albanpetit/labotager/fw-test/images/interface-2.jpg

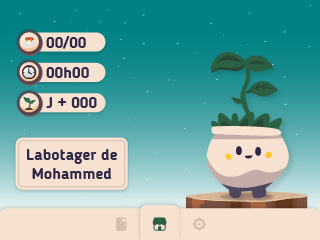
fw-test/images/interface-2.jpg
