albanpetit/labotager/fw-test/images/interface.jpeg

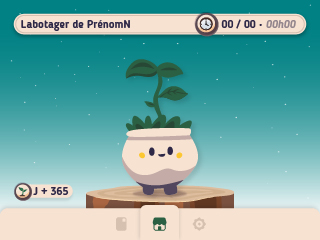
fw-test/images/interface.jpeg
