albanpetit/labotager/fw/tools/images/background.png

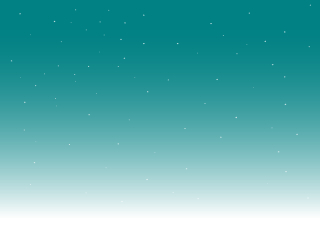
fw/tools/images/background.png
