albanpetit/labotager/fw/tools/images/params_background.png

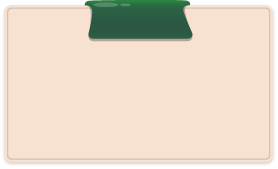
fw/tools/images/params_background.png
