albanpetit/labotager/fw/tools/images/plant_happy.png

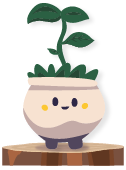
fw/tools/images/plant_happy.png
