albanpetit/labotager/fw/tools/images/plant_unhappy.png

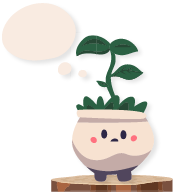
fw/tools/images/plant_unhappy.png
