albanpetit/labotager/mcad/ecad-3d.step

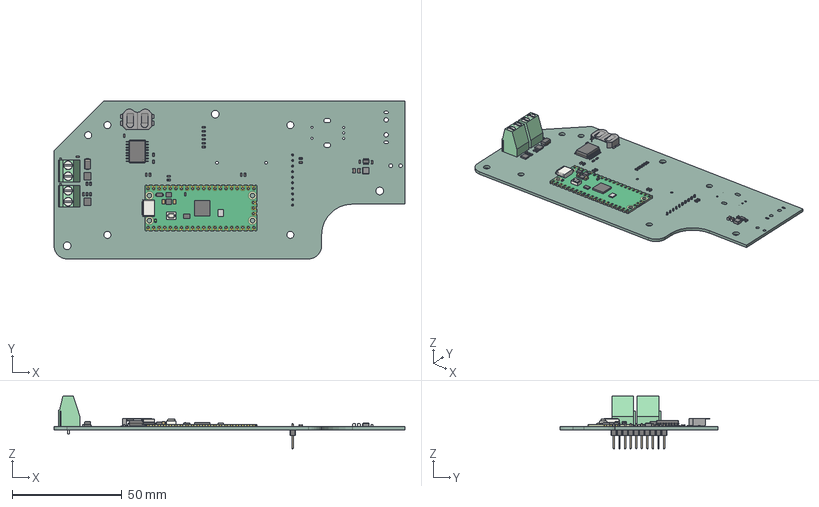
[picture p7: CAD file, 2026-04-15]
mcad/ecad-3d.step
160.0 x 72.0 x 24.0 mm
Diodes_PowerDI3333-8 x 2
C_0603_1608Metric x 13
R_0603_1608Metric x 12
RaspberryPi_Pico_Module_KiCad
C_0805_2012Metric x 2
TerminalBlock_Phoenix_MKDS-1,5-2_1x02_P5.00mm_Horizontal x 2
BatteryHolder_LINX_BAT-HLD-012-SMT
L_Wuerth_MAPI-3015
D_SMA
TSOT-23-6
SOIC-16W_7.5x10.3mm_P1.27mm
PinHeader_1x10_P2.54mm_Vertical
labotager_PCB
