albanpetit/labotager/stencil-support/stencil-support.FCStd

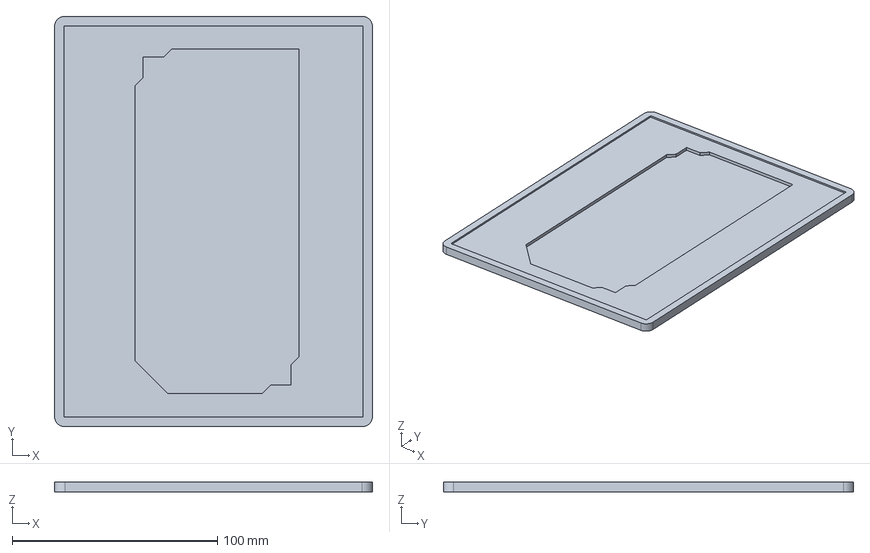
[picture p8: CAD file, 2026-04-15]
stencil-support/stencil-support.FCStd
155.0 x 200.0 x 5.00 mm
