albanpetit/labotager/(list of files, cad)

Other CAD files:
stencil-support/stencil-support.3mf
