albanpetit/labotager/fw-test/images/interface-3.jpg

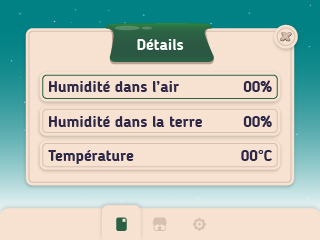
fw-test/images/interface-3.jpg
