albanpetit/labotager/doc/schematic.pdf

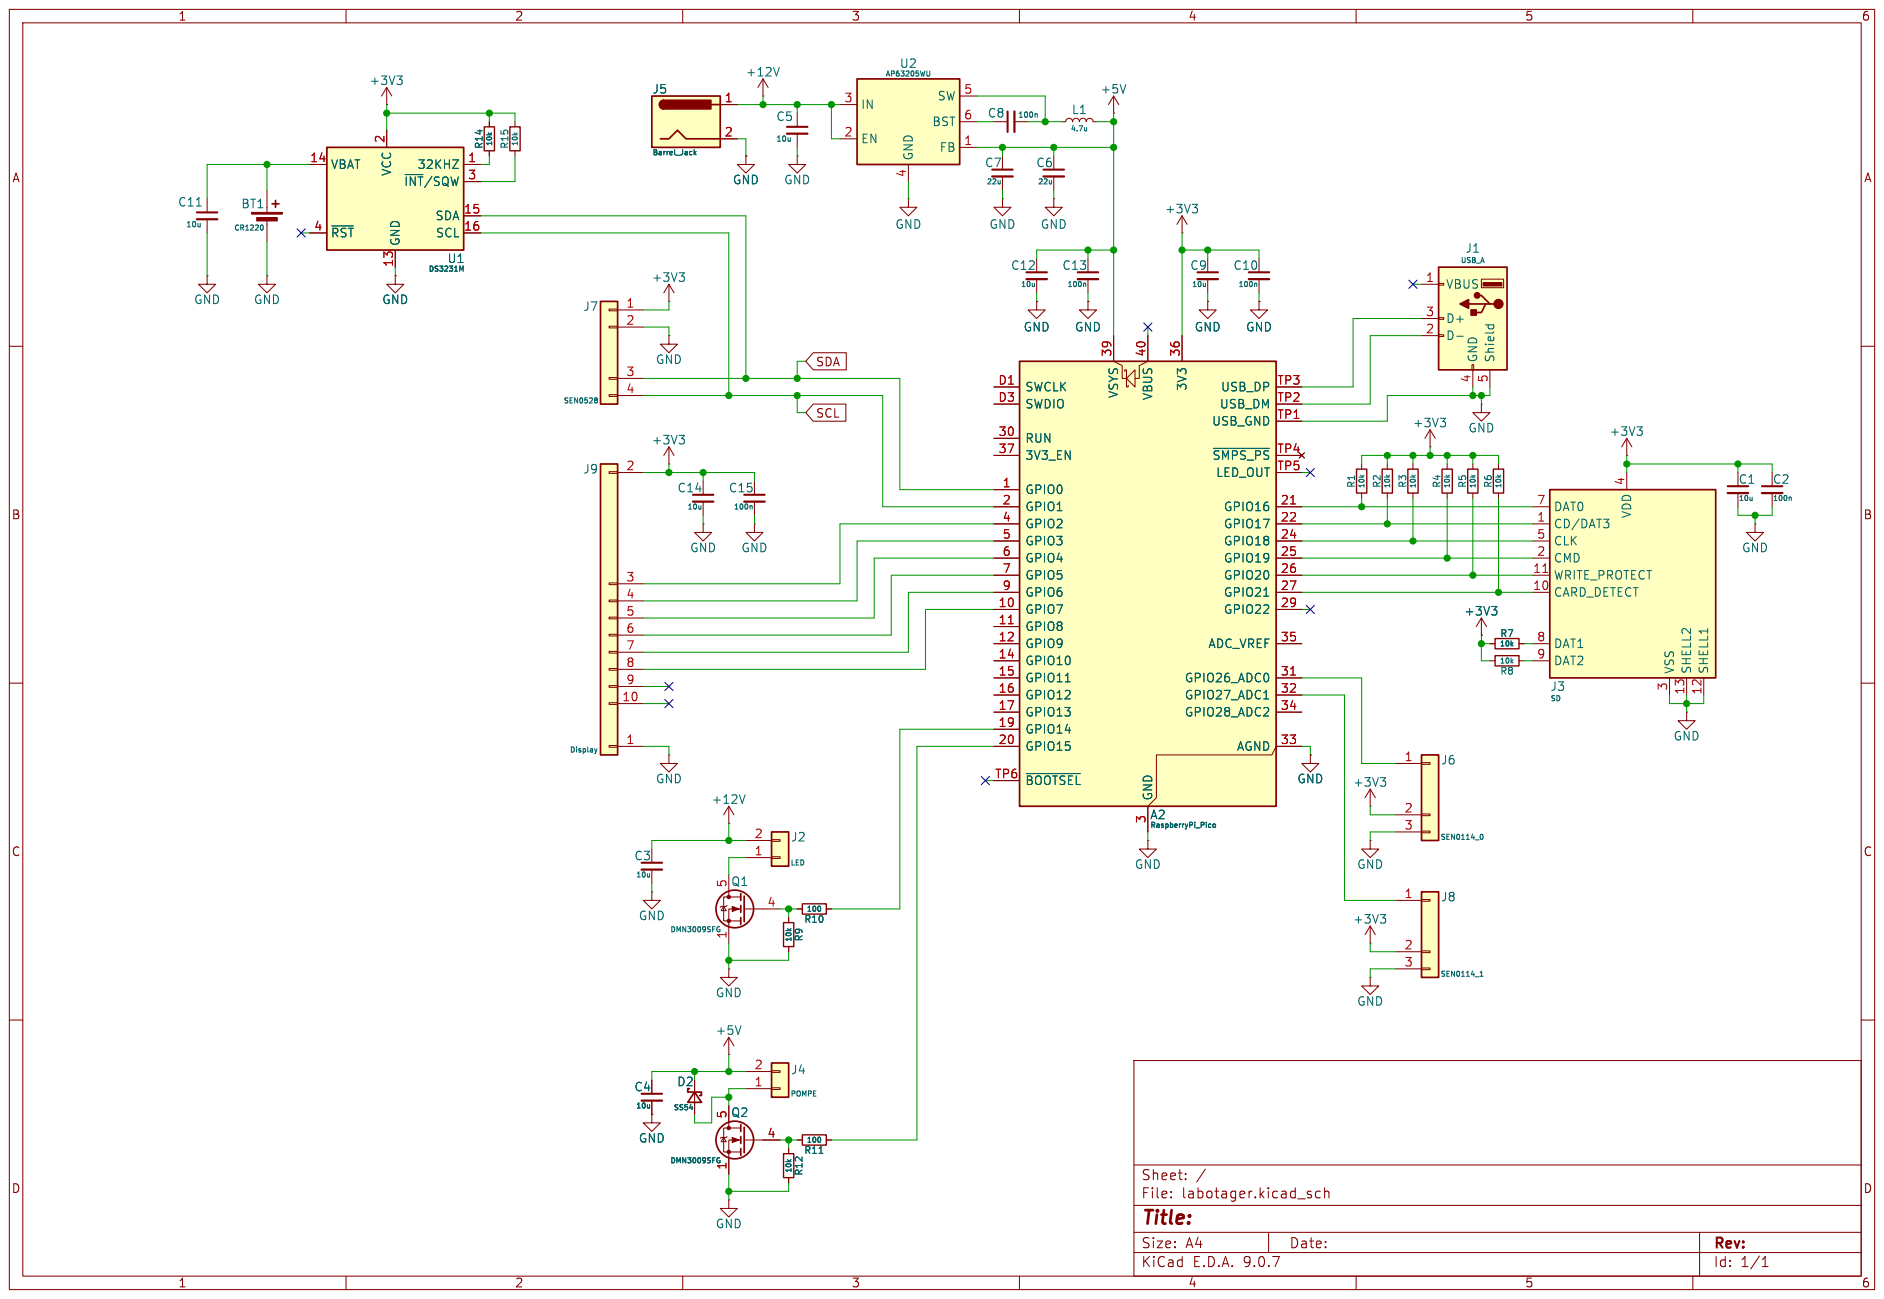
[picture p10: page 1]

Id: 1/1 Title: File: labotager.kicad_sch Sheet: /
