albanpetit/labotager/ecad/labotager.kicad_pcb

## KiCad design ecad/labotager.kicad_pcb (2026-04-15)

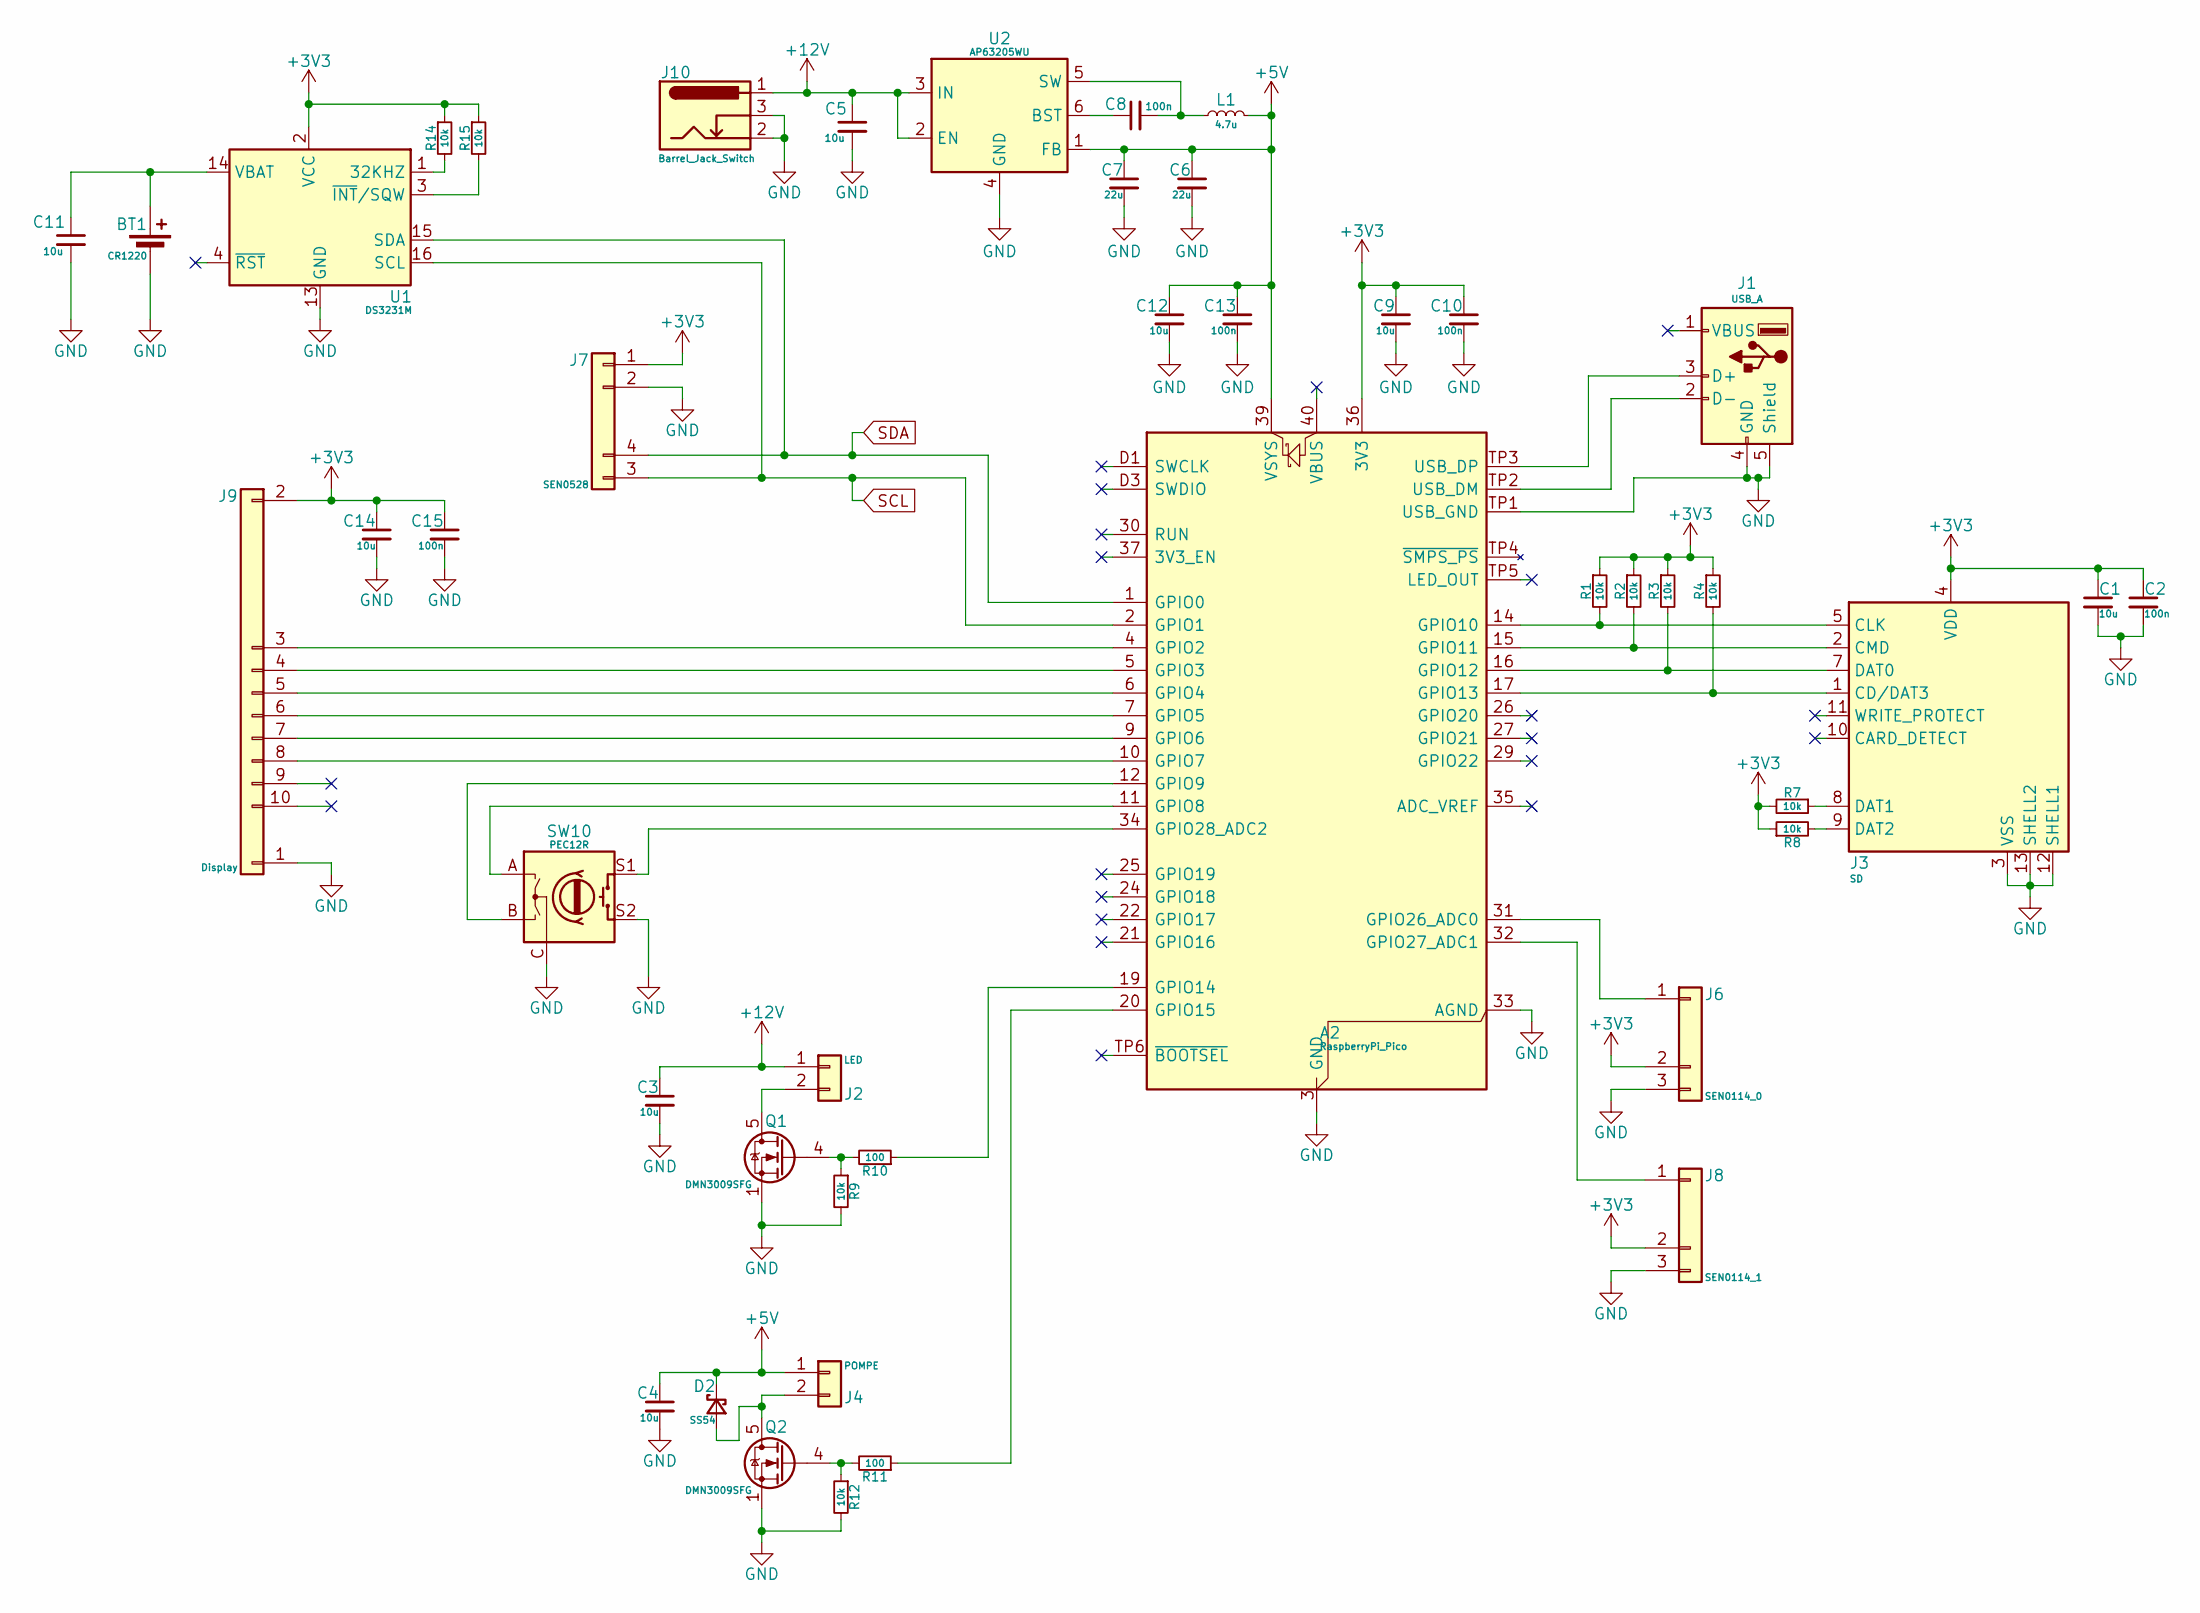
[picture p11: schematic labotager.kicad_sch]

Parts:
A2: RaspberryPi_Pico; RaspberryPi_Pico_SMD
BT1: CR1220; BatteryHolder_LINX_BAT-HLD-012-SMT
C1, C3, C4, C5, C9, C11, C12, C14: 10u; C_0603_1608Metric
C2, C8, C10, C13, C15: 100n; C_0603_1608Metric
C6, C7: 22u; C_0805_2012Metric
D2: SS54; D_SMA
J1: USB_A; USB3_A_Receptacle_Wuerth_692122030100
J2: LED; TerminalBlock_Phoenix_MKDS-1,5-2_1x02_P5.00mm_Horizontal
J3: SD; SD_Hirose_DM1AA_SF_PEJ82
J4: POMPE; TerminalBlock_Phoenix_MKDS-1,5-2_1x02_P5.00mm_Horizontal
J6: SEN0114_0; JST_PH_B3B-PH-SM4-TB_1x03-1MP_P2.00mm_Vertical
J7: SEN0528; JST_PH_B4B-PH-SM4-TB_1x04-1MP_P2.00mm_Vertical
J8: SEN0114_1; JST_PH_B3B-PH-SM4-TB_1x03-1MP_P2.00mm_Vertical
J9: Display; PinHeader_1x10_P2.54mm_Vertical
J10: Barrel_Jack_Switch; BarrelJack_Wuerth_694106106102_2.0x5.5mm
L1: 4.7u; L_Wuerth_MAPI-3015
Q1, Q2: DMN3009SFG; Diodes_PowerDI3333-8
R1, R2, R3, R4, R7, R8, R9, R12, R14, R15: 10k; R_0603_1608Metric
R10, R11: 100; R_0603_1608Metric
SW10: PEC12R; RotaryEncoder_Bourns_Vertical_PEC12R-3x17F-Sxxxx
U1: DS3231M; SOIC-16W_7.5x10.3mm_P1.27mm
U2: AP63205WU; TSOT-23-6

Connections:
+3V3: A2.36 (3V3), C1.1, C2.1, C9.1, C10.1, C14.1, C15.1, J3.4 (VDD), J6.2, J7.1, J8.2, J9.2, R1.1, R2.1, R3.1, R4.1, R7.2, R8.1, R14.1, R15.1, U1.2 (VCC)
+5V: A2.39 (VSYS), C4.1, C6.1, C7.1, C12.1, C13.1, D2.1 (K), J4.1, L1.2, U2.1 (FB)
+12V: C3.1, C5.1, J2.1, J10.1, U2.2 (EN), U2.3 (IN)
GND: A2.3 (GND), A2.8 (GND), A2.13 (GND), A2.18 (GND), A2.23 (GND), A2.28 (GND), A2.33 (AGND), A2.38 (GND), A2.D2 (GND), A2.TP1 (USB_GND), BT1.2 (-), C1.2, C2.2, C3.2, C4.2, C5.2, C6.2, C7.2, C9.2, C10.2, C11.2, C12.2, C13.2, C14.2, C15.2, J1.4 (GND), J1.5 (Shield), J3.3 (VSS), J3.6 (VSS), J3.12 (SHELL1), J3.13 (SHELL2), J6.3, J7.2, J8.3, J9.1, J10.2, J10.3, Q1.1 (S), Q1.2 (S), Q1.3 (S), Q2.1 (S), Q2.2 (S), Q2.3 (S), R9.2, R12.2, SW10.C, SW10.S2, U1.5 (GND), U1.6 (GND), U1.7 (GND), U1.8 (GND), U1.9 (GND), U1.10 (GND), U1.11 (GND), U1.12 (GND), U1.13 (GND), U2.4 (GND)
unnamed: A2.4 (GPIO2), J9.3
unnamed: A2.5 (GPIO3), J9.4
unnamed: A2.6 (GPIO4), J9.5
unnamed: A2.7 (GPIO5), J9.6
unnamed: A2.9 (GPIO6), J9.7
unnamed: A2.10 (GPIO7), J9.8
unnamed: A2.11 (GPIO8), SW10.A
unnamed: A2.12 (GPIO9), SW10.B
unnamed: A2.14 (GPIO10), J3.5 (CLK), R1.2
unnamed: A2.15 (GPIO11), J3.2 (CMD), R2.2
unnamed: A2.16 (GPIO12), J3.7 (DAT0), R3.2
unnamed: A2.17 (GPIO13), J3.1 (CD/DAT3), R4.2
unnamed: A2.19 (GPIO14), R10.1
unnamed: A2.20 (GPIO15), R11.1
unnamed: A2.31 (GPIO26_ADC0), J6.1
unnamed: A2.32 (GPIO27_ADC1), J8.1
unnamed: A2.34 (GPIO28_ADC2), SW10.S1
unnamed: A2.TP2 (USB_DM), J1.2 (D-)
unnamed: A2.TP3 (USB_DP), J1.3 (D+)
unnamed: BT1.1 (+), C11.1, U1.14 (VBAT)
unnamed: D2.2 (A), J4.2, Q2.5 (D)
unnamed: J2.2, Q1.5 (D)
unnamed: J3.8 (DAT1), R7.1
unnamed: J3.9 (DAT2), R8.2
unnamed: Q1.4 (G), R9.1, R10.2
unnamed: Q2.4 (G), R11.2, R12.1
unnamed: R14.2, U1.1 (32KHZ)
unnamed: R15.2, U1.3 (~INT/SQW)
unnamed: C8.1, U2.6 (BST)
unnamed: C8.2, L1.1, U2.5 (SW)
SCL: A2.2 (GPIO1), J7.3, U1.16 (SCL)
SDA: A2.1 (GPIO0), J7.4, U1.15 (SDA)

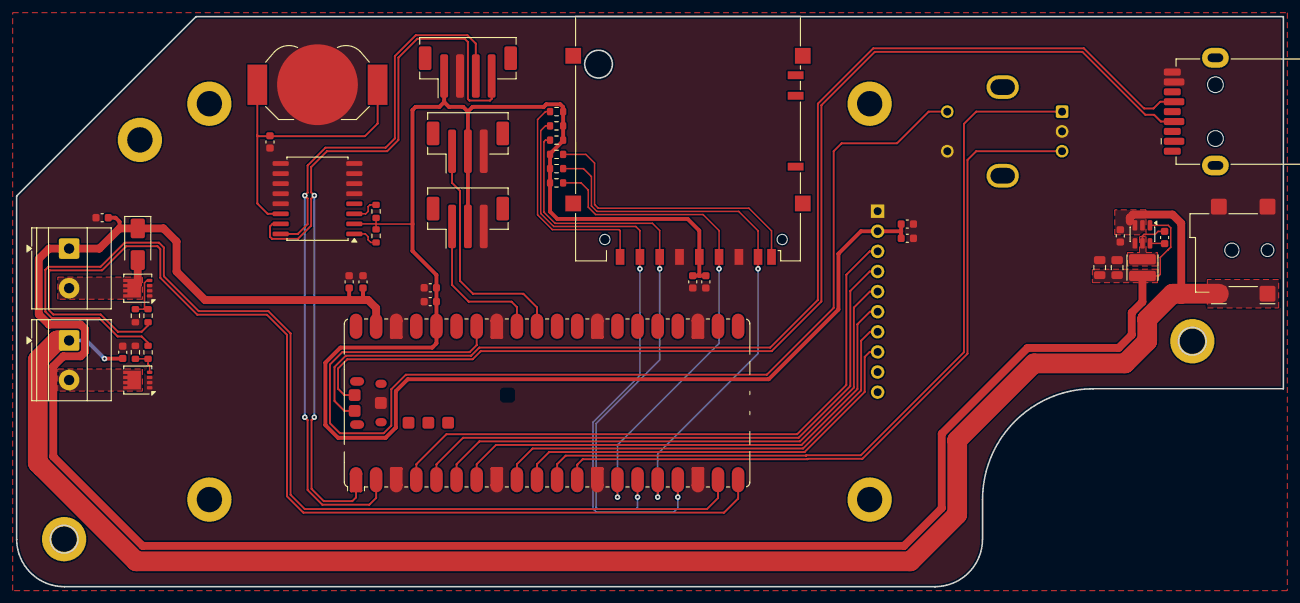
[picture p12: board labotager.kicad_pcb from above]

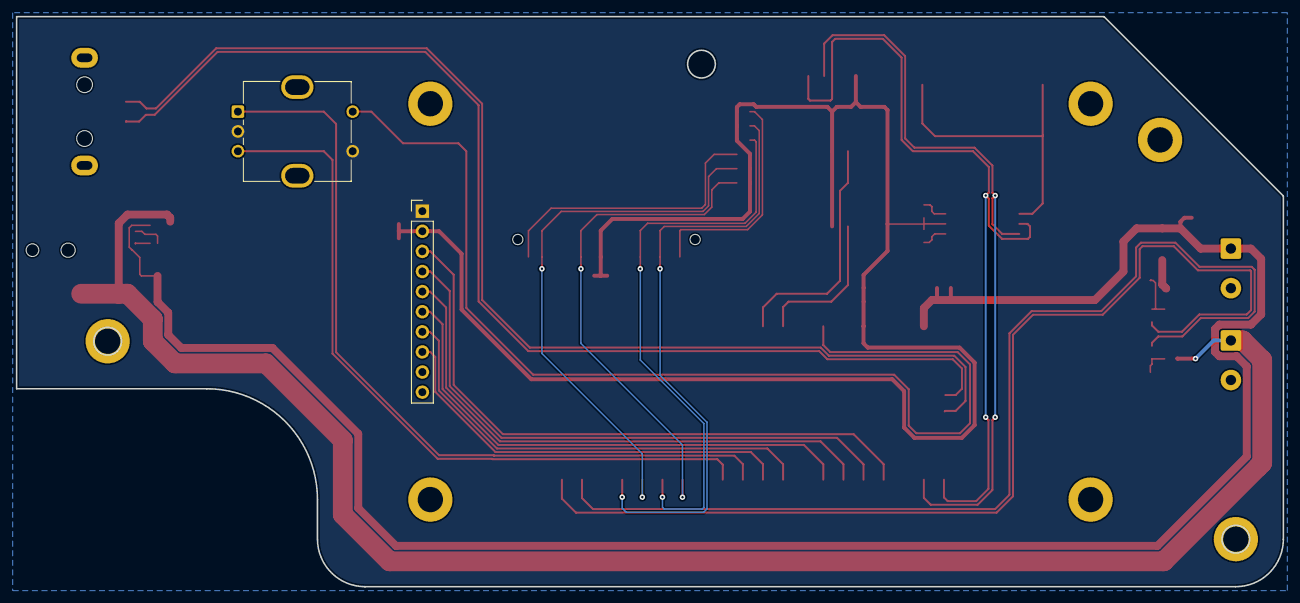
[picture p13: board labotager.kicad_pcb from below]

Board: 2 copper layers, 160.0 x 72.0 mm, 45 parts (2 on the bottom side), 36 nets.
