albanpetit/labotager/fw/src/hw/rtc_mgr.cpp

#include "rtc_mgr.h"
#include "config.h"
#include <Arduino.h>
#include <Wire.h>
#include <DFRobot_DS3231M.h>

// Shared I2C bus (defined in main.cpp)
extern MbedI2C rtcWire;

// RTC update interval
#define RTC_READ_INTERVAL_MS  1000   // minimum time between successive getNowTime() calls (ms)

// DS3231M register addresses (datasheet section 8.2)
#define DS3231_REG_SECONDS   0x00   // start of time registers (seconds … year)
#define DS3231_REG_DOW       0x03   // day-of-week register (not used for time reads)
#define DS3231_REG_STATUS    0x0F   // status register
#define DS3231_STATUS_OSF    0x80   // bit 7 — Oscillator Stop Flag (clear to confirm time is valid)

static DFRobot_DS3231M rtc(&rtcWire);
static bool rtc_failed = false;

// ─── Public ───────────────────────────────────────────────────────────────────

void rtc_init() {
  if (!rtc.begin()) {
    if (Serial) Serial.println("[RTC] DS3231M not detected on I2C bus (addr=0x68) — check wiring");
    rtc_failed = true;
    return;
  }
  if (Serial) Serial.println("[RTC] DS3231M detected and running");

  if (rtc.lostPower()) {
    if (Serial) Serial.println("[RTC] Oscillator was stopped (OSF flag set) — restoring time from build timestamp");

    // Parse __DATE__ ("Mmm DD YYYY") and __TIME__ ("HH:MM:SS") at compile time.
    // Using our own rtc_set_datetime() is explicit and reliable unlike rtc.adjust().
    const char *months = "JanFebMarAprMayJunJulAugSepOctNovDec";
    uint8_t mon = 1;
    for (uint8_t i = 0; i < 12; i++) {
      if (strncmp(__DATE__, months + i * 3, 3) == 0) { mon = i + 1; break; }
    }
    uint8_t  d   = (uint8_t)atoi(__DATE__ + 4);
    uint16_t y   = (uint16_t)atoi(__DATE__ + 7);
    uint8_t  h   = (uint8_t)atoi(__TIME__);
    uint8_t  mi  = (uint8_t)atoi(__TIME__ + 3);
    uint8_t  sec = (uint8_t)atoi(__TIME__ + 6);
    rtc_set_datetime(y, mon, d, h, mi, sec);
  }
}

void rtc_update(SensorData &data) {
  data.rtc_error = rtc_failed;
  if (rtc_failed) return;

  static uint32_t last_read = 0;
  uint32_t now = millis();
  if (now - last_read < RTC_READ_INTERVAL_MS) return;
  last_read = now;

  rtc.getNowTime();

  data.hour      = rtc.hour();
  data.minute    = rtc.minute();
  data.second    = rtc.second();
  data.day       = rtc.day();
  data.month     = rtc.month();
  data.year      = rtc.year();
  data.rtc_ready = true;
}

// Direct register write to DS3231M over I2C.
// Values are BCD-encoded before writing.
// The DFRobot library uses 1970 as year base: stored byte = year - 1970.
void rtc_set_datetime(uint16_t year, uint8_t month, uint8_t day,
                      uint8_t hour, uint8_t minute, uint8_t second) {
  auto to_bcd = [](uint8_t v) -> uint8_t {
    return ((v / 10) << 4) | (v % 10);
  };

  // DS3231M register map — write starting at the seconds register
  rtcWire.beginTransmission(DS3231_ADDR);
  rtcWire.write(DS3231_REG_SECONDS);              // start address
  rtcWire.write(to_bcd(second));                  // 0x00 — seconds
  rtcWire.write(to_bcd(minute));                  // 0x01 — minutes
  rtcWire.write(to_bcd(hour));                    // 0x02 — hours (24-h mode, bits 7:6 = 0)
  rtcWire.write(1);                                // 0x03 — day-of-week (unused, fixed at 1)
  rtcWire.write(to_bcd(day));                     // 0x04 — day-of-month
  rtcWire.write(to_bcd(month));                   // 0x05 — month (century bit 7 = 0)
  rtcWire.write(to_bcd((uint8_t)(year - 1970)));  // 0x06 — year offset from 1970 (DFRobot convention)
  rtcWire.endTransmission();

  // Clear the OSF (Oscillator Stop Flag) in the status register.
  // Without this lostPower() stays true on the next boot and overwrites the time.
  rtcWire.beginTransmission(DS3231_ADDR);
  rtcWire.write(DS3231_REG_STATUS);
  rtcWire.endTransmission();
  rtcWire.requestFrom((int)DS3231_ADDR, 1);
  int raw_status = rtcWire.read();
  if (raw_status >= 0) {
    rtcWire.beginTransmission(DS3231_ADDR);
    rtcWire.write(DS3231_REG_STATUS);
    rtcWire.write((uint8_t)raw_status & ~DS3231_STATUS_OSF);
    rtcWire.endTransmission();
  }

  char buf[56];
  snprintf(buf, sizeof(buf), "[RTC] Time set to %04d-%02d-%02d %02d:%02d:%02d",
      year, month, day, hour, minute, second);
  if (Serial) Serial.println(buf);
}
