albanpetit/labotager/fw-test/src/interface.h

// array size is 64031
static const unsigned char interface[] PROGMEM  = {
  0x89, 0x50, 0x4e, 0x47, 0x0d, 0x0a, 0x1a, 0x0a, 0x00, 0x00, 0x00, 0x0d, 0x49, 0x48, 0x44, 0x52, 
  0x00, 0x00, 0x01, 0x40, 0x00, 0x00, 0x00, 0xf0, 0x08, 0x02, 0x00, 0x00, 0x00, 0xfe, 0x4f, 0x2a, 
  0x3c, 0x00, 0x00, 0x00, 0x01, 0x73, 0x52, 0x47, 0x42, 0x00, 0xae, 0xce, 0x1c, 0xe9, 0x00, 0x00, 
  0x00, 0xf2, 0x65, 0x58, 0x49, 0x66, 0x4d, 0x4d, 0x00, 0x2a, 0x00, 0x00, 0x00, 0x08, 0x00, 0x07, 
  0x01, 0x12, 0x00, 0x03, 0x00, 0x00, 0x00, 0x01, 0x00, 0x01, 0x00, 0x00, 0x01, 0x1a, 0x00, 0x05, 
  0x00, 0x00, 0x00, 0x01, 0x00, 0x00, 0x00, 0x62, 0x01, 0x1b, 0x00, 0x05, 0x00, 0x00, 0x00, 0x01, 
  0x00, 0x00, 0x00, 0x6a, 0x01, 0x28, 0x00, 0x03, 0x00, 0x00, 0x00, 0x01, 0x00, 0x02, 0x00, 0x00, 
  0x01, 0x31, 0x00, 0x02, 0x00, 0x00, 0x00, 0x21, 0x00, 0x00, 0x00, 0x72, 0x01, 0x32, 0x00, 0x02, 
  0x00, 0x00, 0x00, 0x14, 0x00, 0x00, 0x00, 0x94, 0x87, 0x69, 0x00, 0x04, 0x00, 0x00, 0x00, 0x01, 
  0x00, 0x00, 0x00, 0xa8, 0x00, 0x00, 0x00, 0x00, 0x00, 0x00, 0x00, 0x48, 0x00, 0x00, 0x00, 0x01, 
  0x00, 0x00, 0x00, 0x48, 0x00, 0x00, 0x00, 0x01, 0x41, 0x64, 0x6f, 0x62, 0x65, 0x20, 0x49, 0x6c, 
  0x6c, 0x75, 0x73, 0x74, 0x72, 0x61, 0x74, 0x6f, 0x72, 0x20, 0x33, 0x30, 0x2e, 0x32, 0x20, 0x28, 
  0x57, 0x69, 0x6e, 0x64, 0x6f, 0x77, 0x73, 0x29, 0x00, 0x00, 0x32, 0x30, 0x32, 0x36, 0x3a, 0x30, 
  0x32, 0x3a, 0x31, 0x38, 0x20, 0x31, 0x36, 0x3a, 0x30, 0x38, 0x3a, 0x34, 0x37, 0x00, 0x00, 0x04, 
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
  0x61, 0x64, 0x6f, 0x62, 0x65, 0x2e, 0x63, 0x6f, 0x6d, 0x2f, 0x78, 0x61, 0x70, 0x2f, 0x31, 0x2e, 
  0x30, 0x2f, 0x67, 0x2f, 0x69, 0x6d, 0x67, 0x2f, 0x22, 0x0a, 0x20, 0x20, 0x20, 0x20, 0x20, 0x20, 
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
};
