albanpetit/labotager/(commit log)

2026-04-15 chore: untrack .history, add to .gitignore
    [bom.csv, ecad-3d.step, labotager.kicad_pcb, labotager.kicad_sch, stencil-support.3mf, stencil-support.FCStd]
2026-04-15 fix(fw): change the way to exit params edition for a long press
    [display.cpp]
2026-04-15 fix(fw): change params format for date, h:m
    [display.cpp]
2026-04-15 fix(fw): change params date format to j:m:y
    [display.cpp]
2026-04-15 fix(fw): change light logic, start hour and end hour
    [config.h, display.cpp, lighting.cpp, logger.cpp, main.cpp, state.h]
2026-04-15 feat(fw): change pump logic to trigger on light up hours
2026-04-15 fix(fw): change grow counter setup to fix a start date
    [config.h, display.cpp, logger.cpp, main.cpp, state.h]
2026-04-15 fix(fw): fix screen backlight flag to prevent noise on startup
    [display.cpp]
2026-04-15 fix(fw): fix some bugs
    [encoder.cpp, logger.cpp, rtc_mgr.cpp, ui.cpp]
2026-04-15 fix(fw): fix some errors if light up hour is equal to light off
    [display.cpp]
2026-04-15 fix(fw): fix some sd card error
    [display.cpp, logger.cpp, logger.h, main.cpp, ui.cpp, ui.h]
2026-04-16 fix(fw): fix error with screen on startup
    [display.cpp]
2026-04-16 refactor(fw): improve firmware maintainability
    - Sanitize all config.txt values after loading (settings_sanitize):
    clamps hours, temps, thresholds to valid ranges, guards against
    corrupt or hand-edited config producing invalid runtime state
    - Remove last_log_millis from SensorData — it was logger-internal
    scheduling state leaking into the shared struct; now a static local
    in logger_update()
    - Add named constants for DS3231M register addresses and the OSF bit
    mask (DS3231_REG_SECONDS/DOW/STATUS, DS3231_STATUS_OSF); replace
    magic 0x7F mask with ~DS3231_STATUS_OSF for clearer intent
    - Fix double millis() read in rtc_update — single snapshot in `now`
    - Translate remaining French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
    [lighting.cpp, logger.cpp, pump.cpp, rtc_mgr.cpp, state.h]
2026-04-16 refactor(fw): factorize repeated patterns
    - Add minutes_since_midnight(h, m) helper in config.h — replaces the
    inline h*60+m expression duplicated in lighting.cpp (×3) and
    display.cpp apply_delta
    - Extract commit_staged_rtc() in display.cpp — the RTC apply block
    was copy-pasted verbatim in MODE_PARAM_SELECT and MODE_PARAM_EDIT
    LONG_PRESS handlers
    - Merge PARAM_DATE / PARAM_GROW_START rendering in render_param_row
    — both branches were identical except for the data source; unified
    with a ternary to select stg_* vs s.grow_start_*
    - Fix settings_sanitize() declared after first use in logger.cpp
    [config.h, display.cpp, lighting.cpp, logger.cpp]
2026-04-20 refactor(fw): name all remaining magic literals
    - Add timing constants where bare literals remained:
    SOIL_READ_INTERVAL_MS (500), AHT20_INIT_SETTLE_MS (10),
    AHT20_FRAME_BYTES (6) → sensors.cpp
    RTC_READ_INTERVAL_MS (1000) → rtc_mgr.cpp
    SD_RETRY_INTERVAL_MS (5000), SD_HEALTH_INTERVAL_MS (10000)
    → logger.cpp
    HOME_REFRESH_MS (60000) → display.cpp
    - Add ENC_DETENT_TRANSITIONS (4) to config.h — the transitions-per-detent
    count of the PEC12R encoder, used in encoder.cpp accumulator threshold
    - Add UI_COLOR_ERROR_BG (0xC000), UI_COLOR_H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
2026-04-20 refactor(fw): improve maintainability
    - Extract settings_apply_defaults() in logger.h/cpp — centralizes the
    compile-time defaults so adding a new setting only requires updating
    state.h, config.h, and the helper (not also main.cpp setup())
    - Replace raw sw_state integers 0-4 with enum SwState in encoder.cpp
    (SW_IDLE, SW_DEBOUNCE_PRESS, SW_HELD, SW_DEBOUNCE_RELEASE,
    SW_LONG_EMITTED) — state machine is now self-documenting
    - Derive STAGE_COUNT from the STAGE_NAMES array size instead of a
    hardcoded constant, preventing silent divergence if stages are added
    [encoder.cpp, logger.cpp, logger.h, main.cpp]
2026-04-20 refactor(fw): eliminate duplicated logic
    - Extract scroll_update(cursor, scroll, ev, max, shown) → ScrollResult
    in display.cpp — the cursor+scroll arithmetic was duplicated verbatim
    in MODE_DETAILS_SCROLL and MODE_PARAM_SELECT; both now call the helper
    and branch on SCROLL_UNCHANGED / SCROLL_SAME_WINDOW / SCROLL_WINDOW_SHIFTED
    - Extract handle_hw_diag(displayed, error, render_fn, ev) in display.cpp
    — the AHT20 and RTC diagnostic screen blocks were structurally identical;
    both replaced by a single-line call returning false while the screen shows
    [display.cpp]
2026-04-20 refactor(fw): improve readability, maintainability, and reduce duplication
    display.cpp
    - Add LIST_TEXT_X_LEFT/RIGHT/Y_OFFSET constants — removes 50/265/13 magic
    numbers shared between render_details_row and render_param_row
    - Add PARAM_YEAR_MIN/MAX (2024/2069) — year bounds now named, no longer
    duplicated across PARAM_DATE and PARAM_GROW_START branches
    - Add HW_ERROR_MSG_Y/HINT_Y — aligns render_sd_error y position with the
    other error screens (was 180, now consistently 172)
    - Add PARAM_VAL_BUF_LEN / PARAM_LABEL_BUF_LEN — buffer sizes in
    render_param_row are now named constraints
    - Add DetailIndex enum — get_detail_value() switch cases no longer use
    raw integers; item reo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
    [display.cpp, logger.cpp, main.cpp]
2026-04-20 refactor(fw): fix last audit points in display.cpp
    - Rename y → yr in render_param_row: eliminates variable shadowing of the
    outer item-position `y`, removes compiler warning
    - Fix Settings section comment: "10 items total" → "8 items total"
    - Rename HOME_REFRESH_MS → LIVE_REFRESH_MS and update its comment: the
    constant governs both Home (partial update) and Details (full redraw),
    the old name implied Home only
    - Merge DETAILS_ITEM_Y0/STEP/ITEMS_SHOWN and PARAMS_ITEM_Y0/STEP/SHOWN
    into LIST_ITEM_Y0 / LIST_ITEM_STEP / LIST_ITEMS_SHOWN: both screens
    shared identical values; layout changes now require a single edit
    - Add DETAIL_VAL_BUF_LEN (24): names the previously magic char v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
    [display.cpp]
2026-04-21 refactor(fw): fix last audit points in display.cpp and config.h
    - Fix render_home_update comment: the function is called both from
    render_home() on full render and directly by the periodic timer
    (LIVE_REFRESH_MS) for partial updates; the old comment implied
    timer-only
    - Init h = 0, m = 0 in render_param_row: removes -Wmaybe-uninitialized
    warning; the if-else chain always overwrites them but strict compilers
    flag the unguarded declaration
    - Extract render_hw_error_msg(): shared primitive that explicitly sets
    MC_DATUM before drawing the error message line, breaking the implicit
    coupling between render_hw_error() and its callers; render_sd_error()
    and render_hw_error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
    [config.h, display.cpp]
2026-04-21 feat(fw): refresh Details sensor values at 1 Hz without flicker
    Add DETAILS_REFRESH_MS (1000 ms) and last_details_refresh_ms, independent
    from the Home timer (LIVE_REFRESH_MS = 60 s).
    Every second, each visible Details row is redrawn via render_details_row()
    directly — the item background image covers stale text pixels and fresh
    values are painted on top. The global background and title are never
    touched, avoiding the repaint flash that a full do_render pass would cause.
    Both timers are reset on any full render to prevent an immediate
    double-draw after user interaction.
    [display.cpp]
2026-04-21 feat(fw): redesign CSV log format with ID, grow day, and lighting duration
    - New header: id, date, heure, jour_croissance, temp_air_c,
    hum_air_pct, hum_sol_pct, duree_eclairage_min
    - id: auto-incrementing uint32_t; count_log_rows() reads the existing
    file at boot so IDs continue across reboots without persisting state
    - date: DD/MM/YYYY; heure: HH:MM:SS (separate columns, more spreadsheet-
    friendly than the former ISO-8601 datetime)
    - jour_croissance: days since grow_start using Fliegel & Van Flandern
    Julian Day formula (mirrors display.cpp logic, kept local to logger)
    - duree_eclairage_min: scheduled daily LED-on window in minutes, derived
    from led_start/end settings (handles over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
    [logger.cpp]
2026-04-21 fix(fw): change interval of csv export
    [config.h]
2026-04-29 fix(fw): resolve all bugs and quality issues from audit report
    B1 (rtc_mgr): guard OSF-clearing write behind rtcWire.read() >= 0 check —
    a failed read returning -1 would have silently written 0x7F to the
    DS3231M status register, corrupting alarm and BSY bits.
    B2 (rtc_mgr): write literal 1 for the DOW register instead of DS3231_REG_DOW
    (0x03); fix comment to reflect the register is fixed, not "written as 1".
    B3 (logger): emit empty CSV fields for temp/humidity when AHT20 is
    unavailable instead of logging stale or zero-initialised floats.
    B4 (logger): restore log_id on SD hot-plug by calling read_last_log_id()
    after ensure_log_structure() on the reconnect path.
    B5 (main):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
    [display.cpp, logger.cpp, main.cpp, rtc_mgr.cpp, sensors.cpp]
2026-04-29 fix(fw): pin SdFat to exact version 2.2.3
    SdFat versions above 2.2.3 include PIO-SDIO support for RP2040 that
    pulls in Pico SDK headers (hardware/pio.h) incompatible with the
    Arduino-Mbed framework, causing build failures on machines that resolve
    the ^2.2.3 semver range to a newer release.
2026-04-29 docs(tools): add Windows PowerShell instructions to tools/README.md
    Add setup and usage commands for Windows alongside the existing macOS/Linux
    section, including the PowerShell execution policy workaround and the
    Get-Item glob syntax required on Windows.
2026-04-29 fix(tools): expand glob patterns in png2h.py for Windows compatibility
    PowerShell does not expand wildcards for external commands, so *.png was
    passed as a literal string to Python and no files were matched. The script
    now calls glob.glob() on each input argument so wildcard expansion works
    on all platforms. Update the README Windows command accordingly.
2026-05-02 feat(pump): add max watering duration and inter-cycle cooldown
    Watering cycles are now bounded in time and separated by a configurable
    cooldown period to prevent overwatering.
    pump.cpp:
    - Stop the pump after watering_duration_s seconds (default 5 s) even if
    the soil threshold has not been reached yet
    - Block new cycles until watering_cooldown_min minutes have elapsed since
    the last stop (default 30 min)
    - Extract stop_pump() helper to centralise GPIO + state update logic
    - First boot cycle starts immediately (cooldown only applies after the
    first completed cycle)
    config.h:
    - Add DEFAULT_WATERING_DURATION_S (5 s)
    - Add DEFAULT_WATERING_COOLDOWN_MIN (30 min)
    state.h:
    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
    [config.h, display.cpp, logger.cpp, pump.cpp, state.h]
2026-05-02 fix(fw): change name of parameter
    [display.cpp]
2026-05-02 feat(pump): add watering enable/disable toggle
    Add a boolean setting to allow watering to be suspended without changing
    the other watering parameters.
    config.h: add DEFAULT_WATERING_ENABLED (1)
    state.h: add watering_enabled field to Settings
    pump.cpp: gate cycle start on settings.watering_enabled
    logger.cpp: apply default, sanitize, load and save watering_enabled
    under key watering_enabled (0/1) in config.txt
    display.cpp: add PARAM_WATERING_ENABLED entry in the Settings screen
    between soil threshold and watering duration; renders as
    ON/OFF and toggles on any encoder rotation
2026-05-02 feat(display): add configurable screen auto-sleep on encoder inactivity
    After a configurable inactivity period the backlight is cut to save energy
    and avoid light emission. Any encoder event wakes the screen without
    processing the triggering event (prevents accidental navigation).
    config.h: add DEFAULT_SLEEP_ENABLED (1) and DEFAULT_SLEEP_TIMEOUT_MIN (5)
    state.h: add sleep_enabled and sleep_timeout_min fields to Settings
    logger.cpp: apply defaults, sanitize (1–59 min), load and save under keys
    sleep_enabled and sleep_timeout_min in config.txt
    display.cpp:
    - Track last_interaction_ms (initialised on first display_update() call)
    - On timeout: set screen_sleeping, cut TFT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
    [config.h, display.cpp, logger.cpp, state.h]
2026-06-18 fix(sensors): recalibrate soil moisture wet-point to match measured ADC value
    SOIL_WET_VAL was set to 800 but a fully-soaked sample read 71% instead of
    100%, indicating the actual ADC value at saturation is closer to 1583.
    [config.h]
2026-06-18 fix(storage): parse owner_name before numeric validation in config loader
    Every config line was first run through strtol() to validate it as a
    number; owner_name is a text value, so it never contained leading digits
    and was silently dropped before reaching its dedicated handler. As a
    result, editing owner_name on the SD card had no effect after reload.
    [logger.cpp]
2026-06-18 fix(sensors): oversample soil moisture ADC to reject noise spikes
    A single noisy analogRead() sample could momentarily drop soil_pct below
    the watering threshold and trigger the pump even with fully soaked soil,
    since pump_update() reacts to each reading with no debounce. Average 8
    samples per reading cycle to smooth out ADC noise.
    [sensors.cpp]
2026-06-18 fix(storage): harden SD writes against power-loss corruption
    Random parameter resets and unreadable single-letter folders ("N", "M")
    on the SD card pointed to FAT corruption from power loss mid-write.
    - sync() before close() on every critical SD write (log creation, CSV
    rows, config save) to shrink the corruption window.
    - Parse config.txt into a scratch copy and only commit it if a
    config_version sentinel line is present and valid, instead of
    silently merging defaults with whatever fields survived a partially
    corrupted file.
    [config.h, logger.cpp]
2026-06-18 fix(storage): archive log.csv when its header no longer matches the firmware
    A log.csv created by an older firmware version (different columns) kept
    its original header forever, since it's only written when the file is
    first created. New rows from a later firmware version were appended
    underneath that stale header, producing a CSV where data didn't line
    up with column names.
    ensure_log_structure() now checks the existing header against the one
    this build writes, archiving the file to log_old.csv before starting
    a fresh log.csv when they differ. Also updates the README's CSV example
    to the current column layout.
    [logger.cpp]
